amykyta3/skylight_led_controller/doc/Additional BOM.ods

Device | QTY | SKU | Comment
Per main controller
1551JFL | 1 | 1551JFLGY-ND | Flanged enclosure
Connector Receptacle | 2 | 455-2186-ND | Remote light sensor cable
Wire AWG #30, 7-strand |  | Ebay | Remote light sensor cable
1x5 Male header | 2 | Self-stock | To redo LED string end header
12v 5A power brick | 1 | Ebay | http://www.ebay.com/itm/12V-5A-60W-AC-to-DC-Adapter-Power-Supply-for-5050-Flexible-LED-Light-Strip-3528-/301743977266
RGBW LED Strip | 2 | Ebay
PCB mount screws | 2
Per power sense unit
1551N | 1 | HM1126-ND | In-line wire enclosure
2-ended mono cable. 10' | 1 | Ebay | http://www.ebay.com/itm/3m-Mono-Cable-2-5mm-Male-to-2-5mm-Mono-Jack-Plug-Audio-Lead-006420-/381305263387
PCB mount screws | 2
Per booster
1551NFL | 1 | 1551NFLGY-ND | Flanged enclosure
1x5 Female header | 1 | S6103-ND | To redo LED string end header
1x5 Male header | 1 | Self-stock | To redo LED string end header
12v 5A power brick | 1 | Ebay
RGBW LED Strip | 1 | Ebay
PCB mount screws | 2
