amykyta3/skylight_led_controller/doc/Master BOM.ods

Sheet: BOM
Device | Value | Part Reference | QTY | Digikey PN | Stock | Comment
Main Controller
ATXMEGA128D4 | - | U1 | 1 | ATXMEGA128D4-AURCT-ND | 0
C-AL-PAN-D | 22u | C100 | 1 | PCE3920CT-ND | 4
C-CER-0402 | 10p | C2 C3 | 2 | 445-1235-1-ND | 4
C-CER-0603 | 0.1u | C4 C5 C6 C8 C10 | 5 | - | 44
C-CER-0603 | 1u | C7 | 1 | - | 73
C-CER-0603 | 0.01u | C9 | 1 | - | 75
C-CER-0805 | 4.7u | C1 | 1 | 490-1745-1-ND | 20
C-CER-1206 | 0.1u | C12 | 1 | - | 148
C-TANT-3216-18 | 10u | C11 | 1 | 399-3684-1-ND | 4
EIAJ-03 | - | J101 | 1 | CP1-021PJCT-ND | 0
FDN337N | - | M1 M2 M3 M4 M5 M6 M7 M8 | 8 | FDN337NCT-ND | 0
FIN1001M5 | - | U3 | 1 | FIN1001M5XCT-ND | 0
JST_SR-5 | 5 | J102 | 1 | 455-1791-1-ND | 0
LED-0603 | Red | LED2 | 1 | 475-2512-1-ND | 8
LED-1206 | Green | LED1 | 1 | - | 3
MJ1-2503A | 2.5mm | J100 | 1 | CP1-2503AM-ND | 0
PINHD-1X5/90F | - | LEDS_L LEDS_R | 2 | S5441-ND | 0
R-0402 | 1k | R1 | 1 | - | 75
R-0402 | 10k | R2 R4 | 2 | - | 83
R-0402 | 2.2k | R5 R6 R7 R8 | 4 | 311-2.20KLRCT-ND | 8
R-0805 | 330 | R3 R100 | 2 | RHM330CRCT-ND | 10
RN42 | - | BT100 | 1 | 740-1038-ND | 0
TACTILE-6MM-SMT | - | SW1 SW100 | 2 | CKN9087CT-ND | 3
TAR5SB33 | - | U4 | 1 | TAR5SB33(TE85LF)CT-ND | 0
VEML6040 | - | U2 | 1 | VEML6040A3OGCT-ND | 0
XT-2.1X6MM | 32.768k | XT1 | 1 | 300-8762-ND | 0
1551JFL |  |  | 1 | 1551JFLGY-ND |  | Flanged enclosure
Connector Receptacle |  |  | 2 | 455-2186-ND |  | Remote light sensor cable
Wire AWG #30, 7-strand |  |  |  | Ebay |  | Remote light sensor cable
12v 5A power brick |  |  | 1 | Ebay
RGBW LED Strip |  |  | 2 | Ebay
Power Sense
A1C | - | NE1 | 1 | A1C-ND | 0
MJ1-2503A | 2.5mm | J1 | 1 | CP1-2503AM-ND | 0
R-1206 | 47k | R1 | 1 | RHM47KICT-ND | 0
TEPT4400 | - | Q1 | 1 | 751-1057-ND | 0
1551N |  |  | 1 | HM1126-ND |  | In-line wire enclosure
2-ended mono cable. 10' |  |  | 1 | Ebay |  | http://www.ebay.com/itm/3m-Mono-Cable-2-5mm-Male-to-2-5mm-Mono-Jack-Plug-Audio-Lead-006420-/381305263387
Remote Light Sensor
C-CER-0603 | 0.1u | C1 | 1 | - | 44
C-CER-0603 | 1u | C2 | 1 | - | 73
JST_SR-5-RA | 5 | J1 | 1 | 455-1805-1-ND | 0
NCX2200GW | - | U2 | 1 | 568-7526-1-ND | 0
R-0805 | 100 | R1 | 1 | - | 4
VEML6040 | - | U1 | 1 | VEML6040A3OGCT-ND | 0
Booster
EIAJ-03 | - | J100 J101 | 2 | CP1-021PJCT-ND | 0
FDN337N | - | M1 M2 M3 M4 | 4 | FDN337NCT-ND | 0
PINHD-1X5/90F | - | LEDS_OUT | 1 | S5441-ND | 0
R-0402 | 1k | R2 R6 R9 R13 | 4 | - | 75
R-0402 | 10k | R3 R4 R7 R8 R11 R12 R14 R16 | 8 | - | 83
R-0603 | 4.7k | R1 R5 R10 R15 | 4 | 541-4.70KHCT-ND | 0
TLP293-4 | - | U1 | 1 | TLP293-4(GBE-ND | 0
1551NFL |  |  | 1 | 1551NFLGY-ND |  | Flanged enclosure
1x5 Female header |  |  | 1 | 455-2186-ND |  | To redo LED string end header
12v 5A power brick |  |  | 1 | Ebay
RGBW LED Strip |  |  | 1 | Ebay
RS232 Bridge
C-CER-1206 | 0.1u | C1 C2 C3 C4 C5 | 5 | - | 148
F09HP | 9 | X1 | 1 | AE10924-ND | 0
MAX3232ECD | - | U1 | 1 | 296-19851-1-ND | 0

Sheet: digikey order
Device | Value | QTY | Digikey PN
1551JFL |  | 1 | 1551JFLGY-ND
1551NFL |  | 2 | 1551NFLGY-ND
MAX3232ECD | - | 1 | 296-19851-1-ND
XT-2.1X6MM | 32.768k | 1 | 300-8762-ND
JST_SR-5 | 5 | 1 | 455-1791-1-ND
JST_SR-5-RA | 5 | 1 | 455-1805-1-ND
Connector Receptacle |  | 4 | 455-2186-ND
R-0603 | 4.7k | 8 | 541-4.70KHCT-ND
NCX2200GW | - | 1 | 568-7526-1-ND
RN42 | - | 1 | 740-1038-ND
TEPT4400 | - | 1 | 751-1057-ND
A1C | - | 1 | A1C-ND
F09HP | 9 | 1 | AE10924-ND
ATXMEGA128D4 | - | 1 | ATXMEGA128D4-AURCT-ND
EIAJ-03 | - | 3 | CP1-021PJCT-ND
MJ1-2503A | 2.5mm | 2 | CP1-2503AM-ND
FDN337N | - | 16 | FDN337NCT-ND
FIN1001M5 | - | 1 | FIN1001M5XCT-ND
1551N |  | 1 | HM1126-ND
R-1206 | 47k | 1 | RHM47KICT-ND
PINHD-1X5/90F | - | 4 | S5441-ND
TAR5SB33 | - | 1 | TAR5SB33(TE85LF)CT-ND
TLP293-4 | - | 2 | TLP293-4(GBE-ND
VEML6040 | - | 2 | VEML6040A3OGCT-ND
