amykyta3/skylight_led_controller/doc/Power Estimate.ods

Part | mA Each | QTY
Atxmega
Active pwr @ 32 MHz | 12 | 1
32k Osc | 0.029 | 1
32M osc | 0.245 | 1
PLL | 0.29 | 1
EEPROM Programming | 4 | 1
 |  | 1
RN42 Bluetooth | 50 | 1
VEML6040 Light Sensor | 0.2 | 2
LVDS Driver+term | 10 | 1
LVDS Comparitor | 0.006 | 1
Power Sense | 0.3 | 1
Total | 77.27
