amykyta3/skylight_led_controller/(threads)

Thread 1 (2016-07-07):

Improve Bluetooth enumeration/connection

amykyta3, 2016-07-07:
Currently, Python scripts are hard coded to use /dev/rfcomm0, and assume the serial port is already connected. Rework btLink to have a better API that is specific to Bluetooth:
* btLink assumes you have already paired the devices (let the existing OS interface handle this)
* Command to query BT devices (that have been paired?)
* Open connection by specifying HW address (instead of /dev/ path)
** Connection automatically opens serial rfcomm connection
** Automatically determines rfcomm dev path

In GUI:
* Use/save previously used HW address in settings.json
* If no previous HW address in settings, query BT devices, and list all that match the name "SkylightLED-XXXX". Ask user which to use.

Closed 2016-07-08.

Thread 2 (2016-07-07):

Rework GUI color selection

amykyta3, 2016-07-07:
No longer bothering to do actual color approximation between LEDs RGBW <--> Display RGB
Instead of using native Tk color chooser, build my own to select RGBW channels directly.
* 4 sliders for raw RGBW value, 0x0000 - 0xFFFF
* Checkbox to enable "live preview"
** On change, send the color to the device
* OK/Cancel button

Closed 2016-07-08.

Thread 3 (2016-07-07):

Implement clock drift correction

amykyta3, 2016-07-07:
Clock drifts a few minutes after a couple of weeks.
Implement a mechanism to correct for this.

**Firmware:**
* Configuration setting to set a correction interval where every N minutes, skip/insert a minute.
* When the minute tick interrupt fires, check if the correction interval expired.
  * If correction direction is set to insert a minute (correcting for fast clock), then this interrupt is skipped. Contents are not executed.
  * If correction direction is set to skip a minute (correcting for slow clock), contents of this interrupt fire twice.
* Store timestamp in RAM of the last time the date/time was set,

**Software:**
* In the sync date/time function, instead of just overwriting the date/time, do the following:
  * If the date/time was already set in the hardware, get the hardware's time (T_hw) and the timestamp of when it was last set (T_ref)
    * If a correction interval was already in use, back-calculate what T_hw _would_ have been without it
    * If was correcting for a fast clock: T_hw = T_hw_corrected / (1-1/Interval)
    * If was correcting for a slow clock: T_hw = T_hw_corrected / (1+1/Interval)
  * Compare with actual time (T_now) and calculate the average drift rate (minutes / minute): R_d = (T_hw - T_now) / (T_now - T_ref)
  * Correction interval is: I_c = 1/abs(R_d)
  * If R_d is positive (clock is fast), insert a minute every interval. If negative, skip a minute.
* Only update the correction interval if the measurement period was significant enough

Closed 2016-07-17.

Thread 5 (2016-07-09):

Redesign power sense circuit

amykyta3, 2016-07-09:
Current power sensing circuit is a neon lamp-based optocoupler.
Apparently, neon lamps need a few stray photons to trigger lamp ignition. Therefore, in very dark environments (ie, in an enclosure) it sometimes takes a few seconds for the lamp to ignite.

Redesign so that power-on sense is immediate.

Closed 2017-01-14.
