amykyta3/skylight_led_controller/software/py_modules/skylight.py

import serial
import logging
import time

class CMDError(Exception):
    pass

class Skylight:
    def __init__(self, port, timeout = 10):
        self.S = serial.Serial()
        self.S.port = port
        self.S.timeout = timeout
        self.S.baudrate = 115200
        self.log = logging.getLogger("skylight")
        
    #-----------------------------------------------------------------------------------------------
    def __enter__(self):
        self.open()
        return(self)
    
    #-----------------------------------------------------------------------------------------------
    def __exit__(self, type, value, traceback):
        self.close()
    
    #-----------------------------------------------------------------------------------------------
    def open(self):
        self.S.open()
        
        # flush out any partial commands
        try:
            self.cmd("\r\n")
        except CMDError:
            # ignore.
            pass
        
    
    #-----------------------------------------------------------------------------------------------
    def close(self):
        self.S.close()
    
    #-----------------------------------------------------------------------------------------------
    def cmd(self, cmd_string):
        """
        Sends command string and waits for response
        Response ends once '>' is received
        If response spans multiple lines, splits into a list
        If no response, returns ""
        If timeout, raises TimeoutError
        If last line of response is "ERR", raises IOError 
        """
        self.log.debug("cmd: %s" % cmd_string.strip())
        cmd_string = cmd_string.encode("ascii")
        self.S.reset_input_buffer()
        self.S.write(cmd_string)
        
        # Collect response
        resp = []
        resp_line = ""
        
        c = self.S.read(1).decode("ascii")
        while(c != '>'):
            if(c == ''):
                # Timed out
                raise TimeoutError("Timed out waiting for a response")
            elif(c == '\r'):
                # discard
                pass
            elif(c == '\n'):
                # Got newline
                if(len(resp_line) != 0):
                    self.log.debug("resp_line: %s" % resp_line)
                    resp.append(resp_line)
                    resp_line = ""
            else:
                resp_line += c
            
            c = self.S.read(1).decode("ascii")
        
        if(len(resp_line) != 0):
            self.log.debug("resp_line: %s" % resp_line)
            resp.append(resp_line)
            resp_line = ""
        
        # if no response, fill with empty
        if(len(resp) == 0):
            resp = [""]
            
        # Check if last line is error response
        if(resp[len(resp)-1] == "ERR"):
            raise CMDError("Command responded with an error")
        
        # If one response line, collapse
        elif(len(resp) == 1):
            resp = resp[0]
        
        return(resp)
    
    #-----------------------------------------------------------------------------------------------
    def enter_bootloader(self):
        """
        Check if in bootloader. If not, enter it
        """
        
        if(self.cmd("id\r\n") == "BL"):
            return
        
        self.cmd("reset\r\n")
            
        if(self.cmd("id\r\n") != "BL"):
            raise CMDError("Failed to enter bootloader")

    #-----------------------------------------------------------------------------------------------
    def exit_bootloader(self):
        """
        Check if in bootloader. If so, exit it
        """
        
        if(self.cmd("id\r\n") != "BL"):
            return
        
        self.cmd("boot\r\n")
            
        if(self.cmd("id\r\n") == "BL"):
            raise CMDError("Failed to exit bootloader")
    
    #-----------------------------------------------------------------------------------------------
    def send_ihex(self, filename):
        self.log.info("Sending file: %s" % filename)
        with open(filename, 'r') as f:
            for line in f:
                line = line.strip()
                self.cmd("ihex %s\r\n" % line)
        
    #-----------------------------------------------------------------------------------------------
    def set_time(self):
        now = time.localtime()
        self.cmd("set_time %x %x %x %x %x %x\r\n" % (
            now.tm_year,
            now.tm_mon,
            now.tm_mday,
            now.tm_hour,
            now.tm_min,
            now.tm_sec
        ))
        
        self.cmd("set_dst %d %d\r\n" % (time.daylight, now.tm_isdst))
    
