amykyta3/skylight_led_controller/(commit log)

2015-12-12 Initial repo
    [Additional BOM.ods, Master BOM.ods, PANELIZED.brd, Power Estimate.ods, booster.brd, booster.sch, main_controller.brd, main_controller.sch]
2015-12-30 Fixed bad gerber export
    [booster.sch, main_controller.sch]
2016-01-10 errata annotations. Updated component values
    [main_controller.brd, main_controller.sch, power_sense.brd]
2016-01-10 played around with color conversion ideas
    [LED color conversion.ods]
2016-01-10 Initial PWM app code
2016-01-16 Fixed bt init issues
    [bt_rn42.c, bt_rn42.h, main.c]
2016-02-05 Reworked firmware loader. Sets date/time
    [cli_commands.c, skylight.py]
2016-02-13 RTC timer & calendar seems to work
2016-02-18 Switched config to use absolute pointers
2016-02-22 Added preliminary light switch code
2016-03-03 Implemented CIELAB lightness correction to LED PWM values
    [CIELAB Lightness Approximation.ods]
2016-03-05 Added blinker error for no datetime set
    [cli_commands.c, main.c]
2016-03-06 Added color tester. Added current config
2016-03-19 Implemented chroma sensor
2016-04-25 Upgraded to better class encoder. Other misc changes...
2016-07-09 Added clock correction support to firmware. #3
    [cli_commands.c, eeprom_config.c, eeprom_config.h]
2016-07-17 Integrated clock correction into GUI. Completes #3
    [cli_commands.c]
2017-01-14 Redesign power sense circuit. Works! Fixes #5
    [power_sense_v2.brd, power_sense_v2.sch]
